jeffangelion/PicoPost/docs/images/schematic_lpc.png

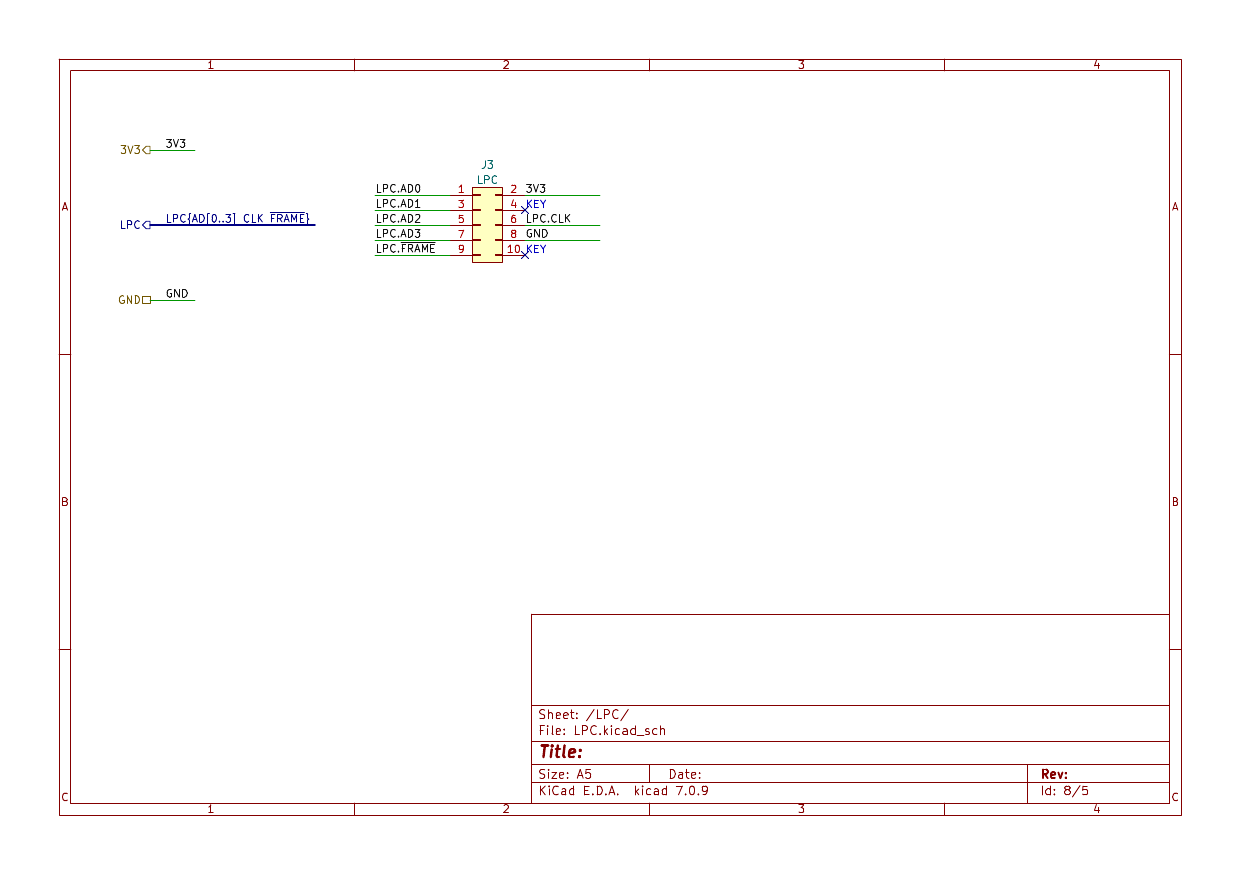
docs/images/schematic_lpc.png
