jeffangelion/PicoPost/docs/images/schematic_som.png

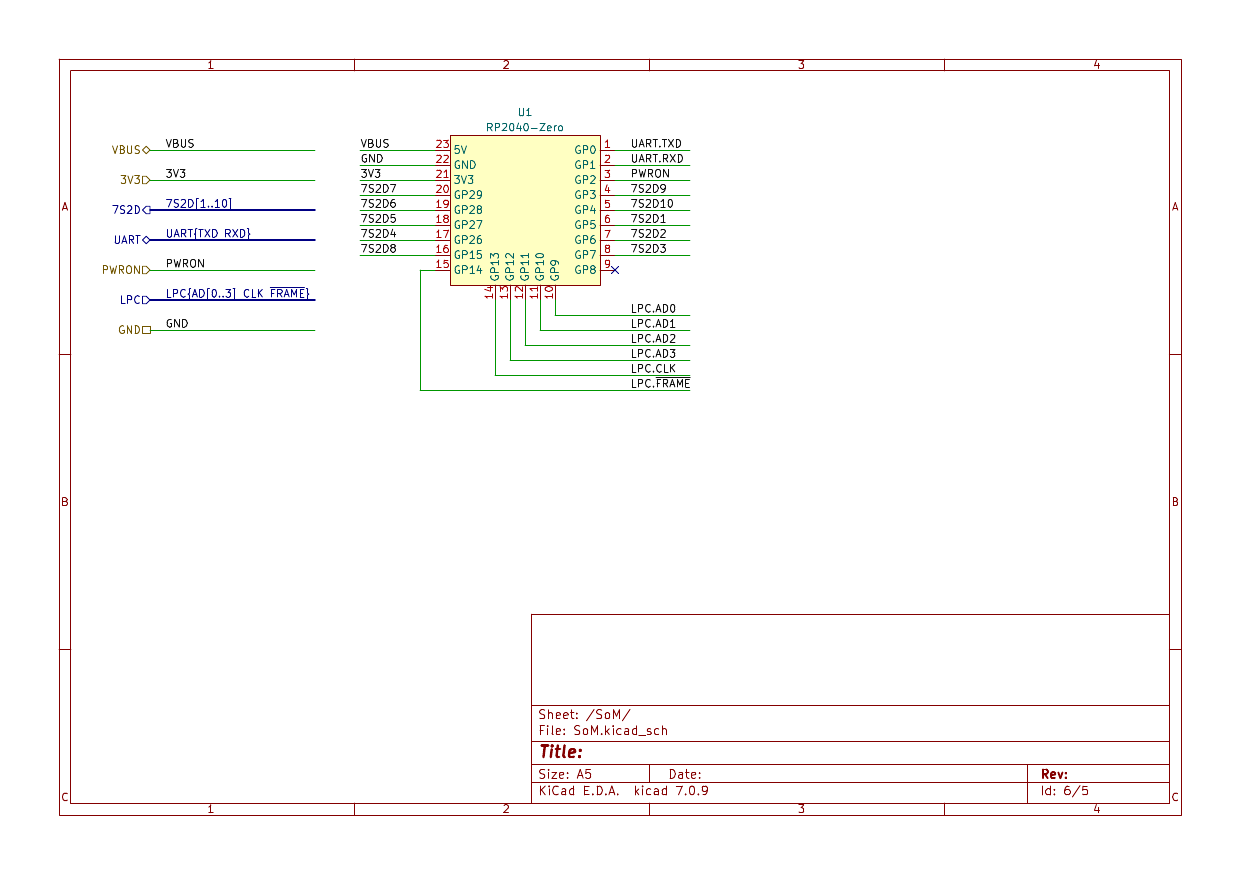
docs/images/schematic_som.png
