jeffangelion/PicoPost/hardware/enclosure/PicoPost_Case.step

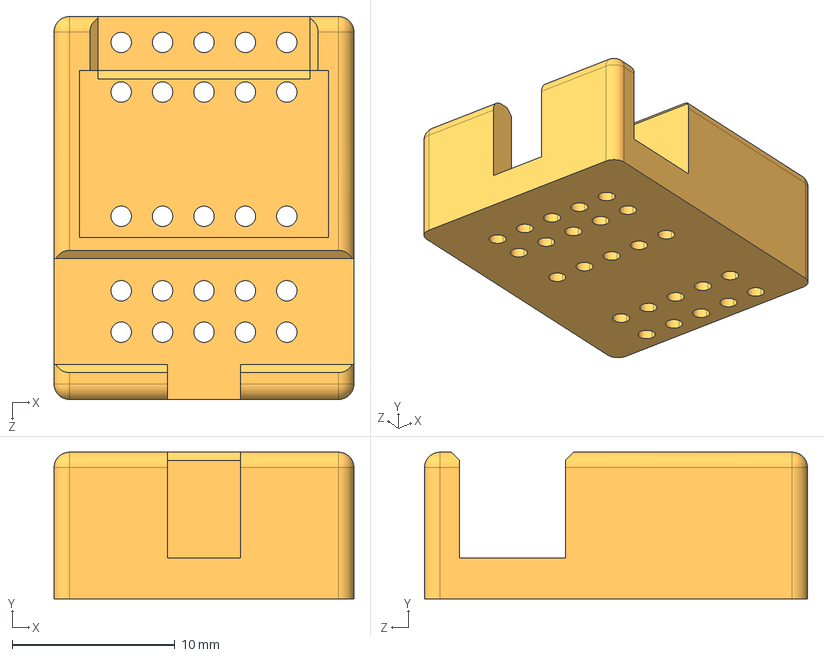
[picture p12: CAD file, 2026-11-07]
hardware/enclosure/PicoPost_Case.step
18.4 x 9.00 x 23.5 mm
