jeffangelion/PicoPost/hardware/kicad/PinHeader_2x05_P2.54mm_Vertical.step

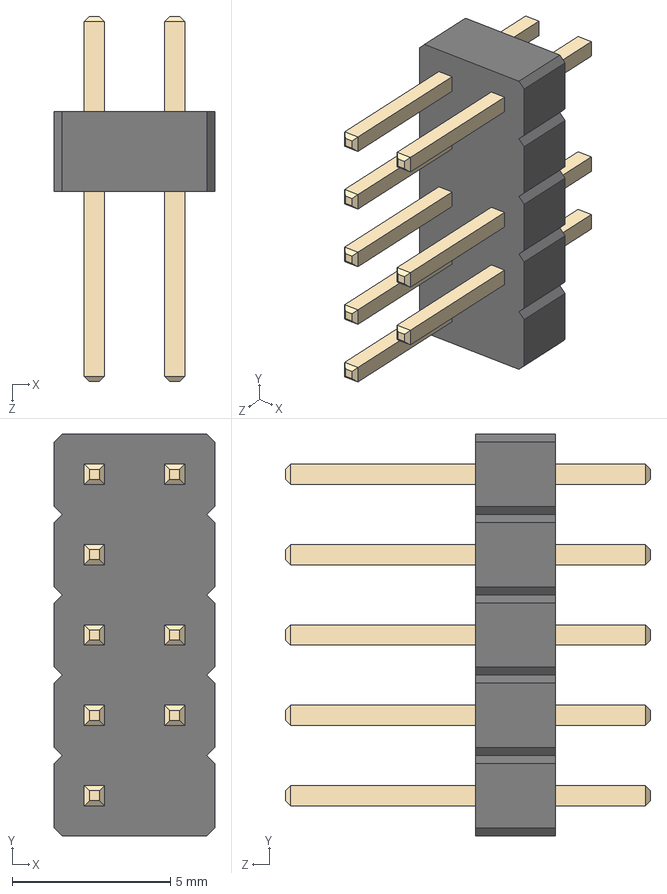
[picture p13: CAD file, 2026-11-07]
hardware/kicad/PinHeader_2x05_P2.54mm_Vertical.step
5.08 x 12.7 x 11.5 mm
