jeffangelion/PicoPost/hardware/PicoPost_Schematic.pdf

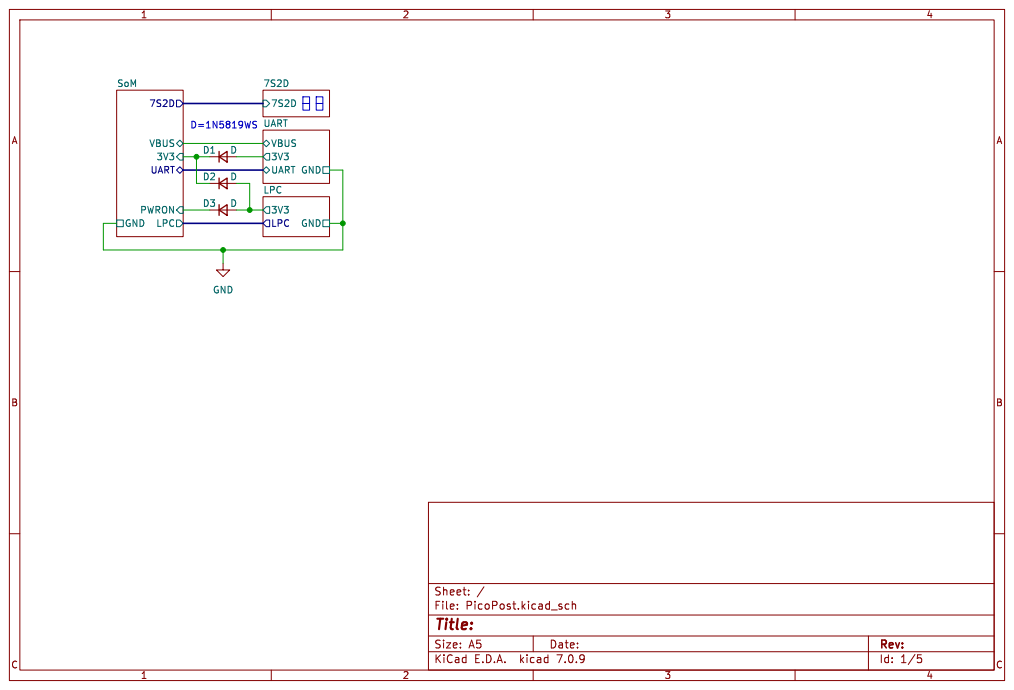
[picture p14: page 1]

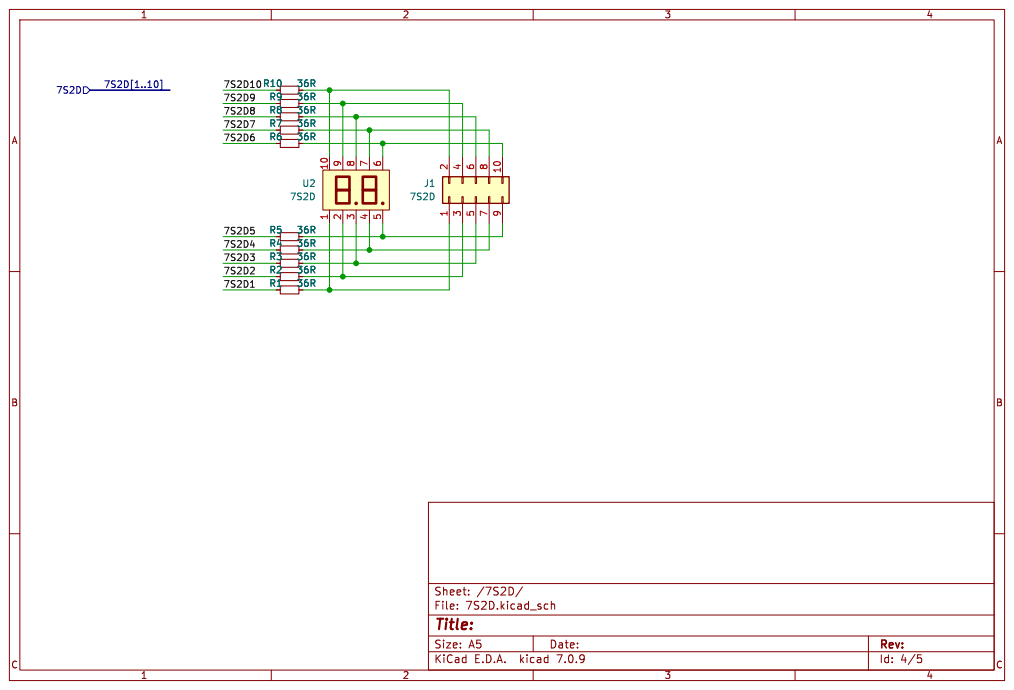
[picture p15: page 2]

Id: 4/5 Title: File: 7S2D.kicad_sch Sheet: /7S2D/

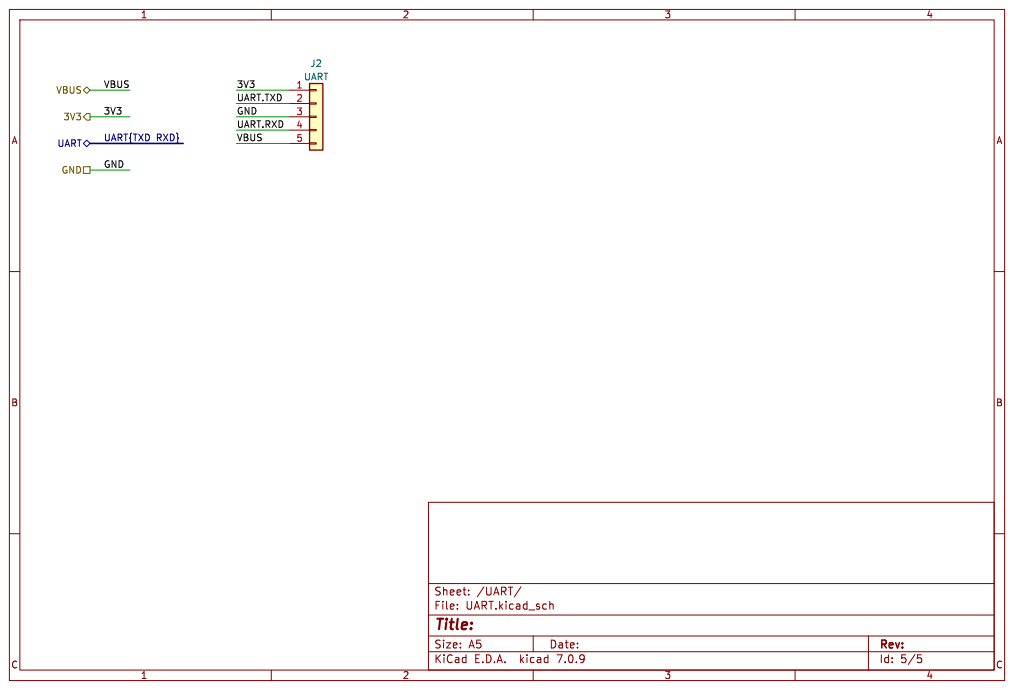
[picture p16: page 3]

UART{TXD RXD} GND

Id: 5/5 Title: File: UART.kicad_sch Sheet: /UART/

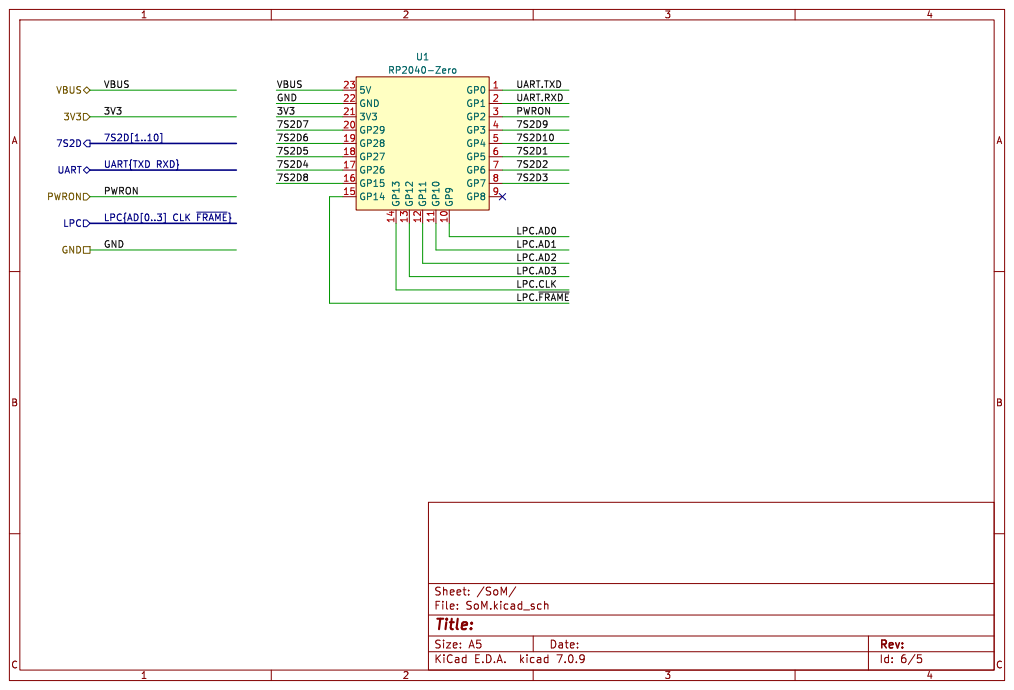
[picture p17: page 4]

UART{TXD RXD} GND

Id: 6/5 Title: File: SoM.kicad_sch Sheet: /SoM/

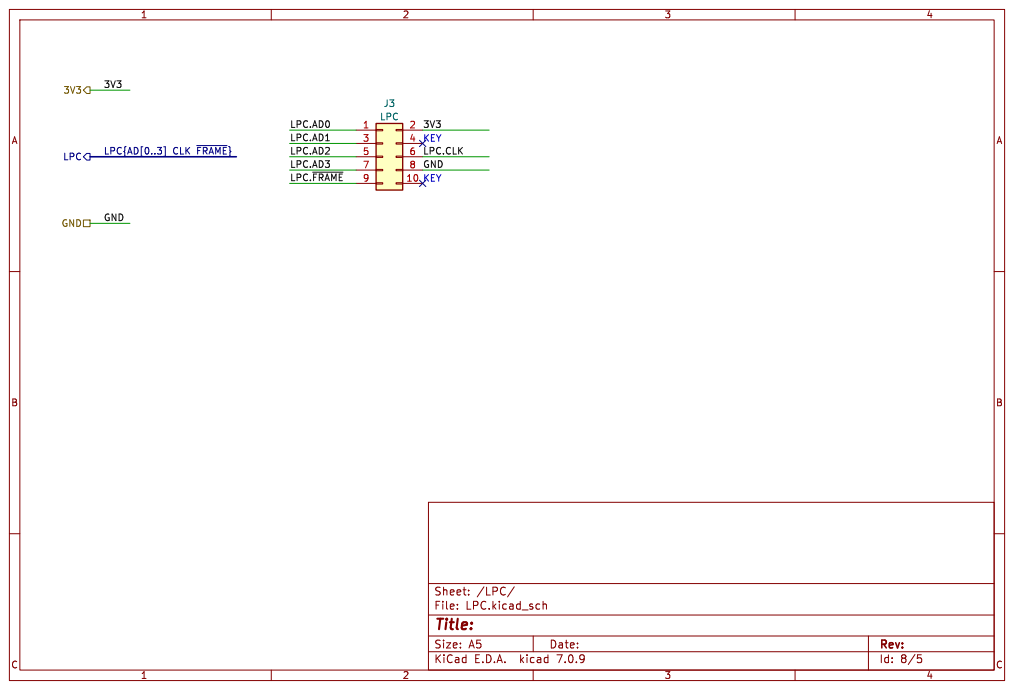
[picture p18: page 5]
