jeffangelion/PicoPost/hardware/kicad/PicoPost.kicad_pcb

## KiCad design hardware/kicad/PicoPost.kicad_pcb (2026-11-07)

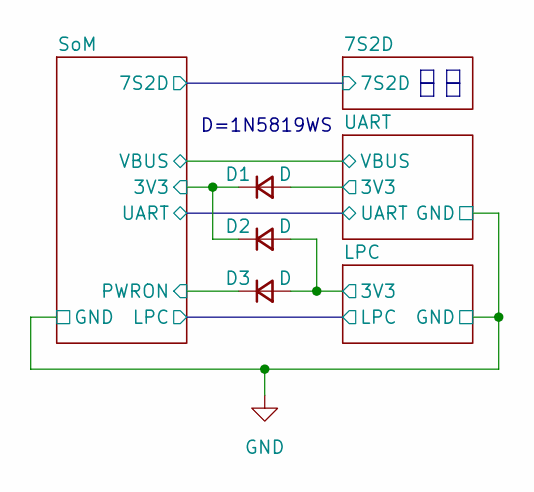
[picture p19: schematic PicoPost.kicad_sch]

Parts:
D1, D2, D3: D; D_SOD-323

Connections:
/LPC/3V3: D2.2 (A), D3.2 (A); also elsewhere on the board
/SoM/3V3: D1.1 (K), D2.1 (K); also elsewhere on the board
/SoM/PWRON: D3.1 (K); also elsewhere on the board
/UART/3V3: D1.2 (A); also elsewhere on the board

Notes on the sheet:
D=1N5819WS

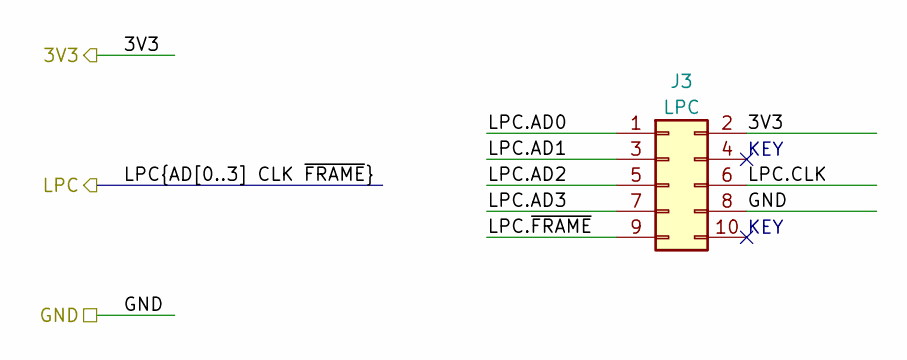
[picture p20: schematic LPC.kicad_sch]

Parts:
J3: LPC; PinHeader_2x05_P2.54mm_Vertical

Connections:
/LPC/3V3: J3.2; also elsewhere on the board
/LPC/LPC.AD0: J3.1; also elsewhere on the board
/LPC/LPC.AD1: J3.3; also elsewhere on the board
/LPC/LPC.AD2: J3.5; also elsewhere on the board
/LPC/LPC.AD3: J3.7; also elsewhere on the board
/LPC/LPC.CLK: J3.6; also elsewhere on the board
/LPC/LPC.~FRAME: J3.9; also elsewhere on the board
GND: J3.8; also elsewhere on the board

Notes on the sheet:
KEY

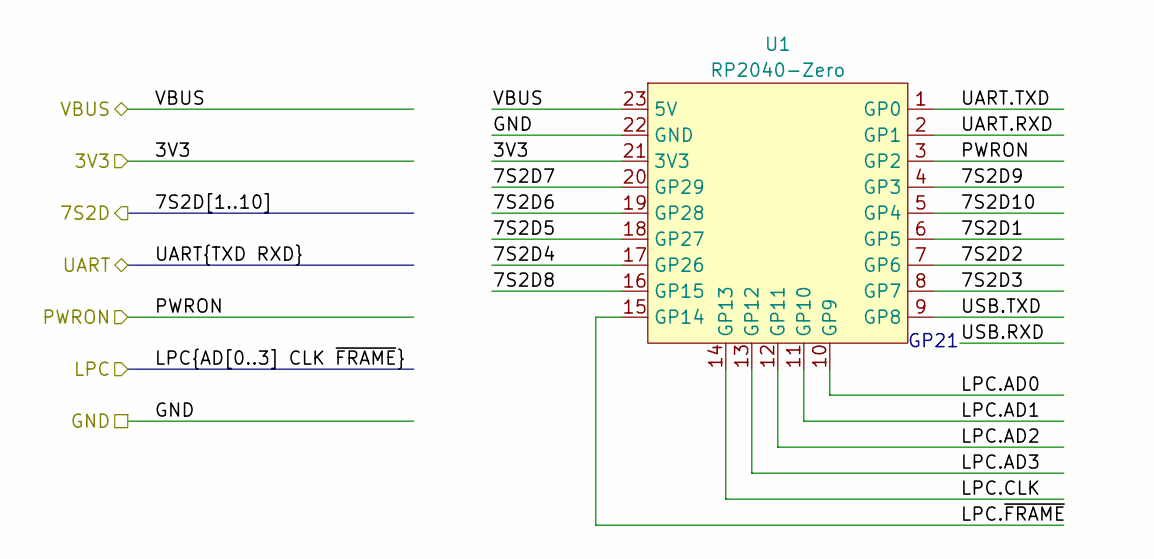
[picture p21: schematic SoM.kicad_sch]

Parts:
U1: RP2040-Zero; RP2040-Zero TNT

Connections:
/7S2D/7S2D1: U1.6 (GP5); also elsewhere on the board
/7S2D/7S2D2: U1.7 (GP6); also elsewhere on the board
/7S2D/7S2D3: U1.8 (GP7); also elsewhere on the board
/7S2D/7S2D4: U1.17 (GP26); also elsewhere on the board
/7S2D/7S2D5: U1.18 (GP27); also elsewhere on the board
/7S2D/7S2D6: U1.19 (GP28); also elsewhere on the board
/7S2D/7S2D7: U1.20 (GP29); also elsewhere on the board
/7S2D/7S2D8: U1.16 (GP15); also elsewhere on the board
/7S2D/7S2D9: U1.4 (GP3); also elsewhere on the board
/7S2D/7S2D10: U1.5 (GP4); also elsewhere on the board
/LPC/LPC.AD0: U1.10 (GP9); also elsewhere on the board
/LPC/LPC.AD1: U1.11 (GP10); also elsewhere on the board
/LPC/LPC.AD2: U1.12 (GP11); also elsewhere on the board
/LPC/LPC.AD3: U1.13 (GP12); also elsewhere on the board
/LPC/LPC.CLK: U1.14 (GP13); also elsewhere on the board
/LPC/LPC.~FRAME: U1.15 (GP14); also elsewhere on the board
/SoM/3V3: U1.21 (3V3); also elsewhere on the board
/SoM/PWRON: U1.3 (GP2); also elsewhere on the board
/SoM/UART.RXD: U1.2 (GP1); also elsewhere on the board
/SoM/UART.TXD: U1.1 (GP0); also elsewhere on the board
/SoM/VBUS: U1.23 (5V); also elsewhere on the board
GND: U1.22 (GND); also elsewhere on the board

Notes on the sheet:
GP21

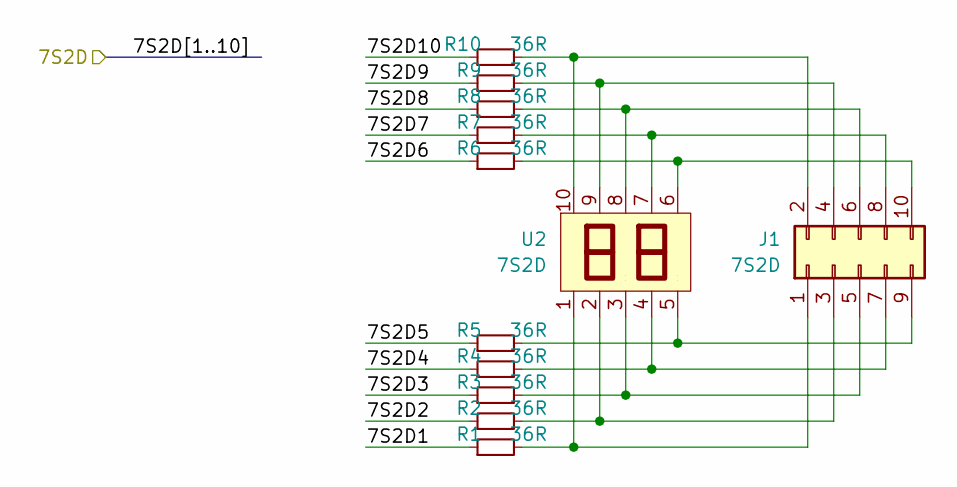
[picture p22: schematic 7S2D.kicad_sch]

Parts:
J1: 7S2D; PinHeader_2x05_P2.54mm_Vertical_SMD
R1, R2, R3, R4, R5, R6, R7, R8, R9, R10: 36R; R_0805_2012Metric
U2: 7S2D; Display_7S2D_10Pin_150x100

Connections:
/7S2D/7S2D1: R1.1; also elsewhere on the board
/7S2D/7S2D2: R2.1; also elsewhere on the board
/7S2D/7S2D3: R3.1; also elsewhere on the board
/7S2D/7S2D4: R4.1; also elsewhere on the board
/7S2D/7S2D5: R5.1; also elsewhere on the board
/7S2D/7S2D6: R6.1; also elsewhere on the board
/7S2D/7S2D7: R7.1; also elsewhere on the board
/7S2D/7S2D8: R8.1; also elsewhere on the board
/7S2D/7S2D9: R9.1; also elsewhere on the board
/7S2D/7S2D10: R10.1; also elsewhere on the board
unnamed: J1.1, R1.2, U2.1
unnamed: J1.2, R10.2, U2.10
unnamed: J1.3, R2.2, U2.2
unnamed: J1.4, R9.2, U2.9
unnamed: J1.5, R3.2, U2.3
unnamed: J1.6, R8.2, U2.8
unnamed: J1.7, R4.2, U2.4
unnamed: J1.8, R7.2, U2.7
unnamed: J1.9, R5.2, U2.5
unnamed: J1.10, R6.2, U2.6

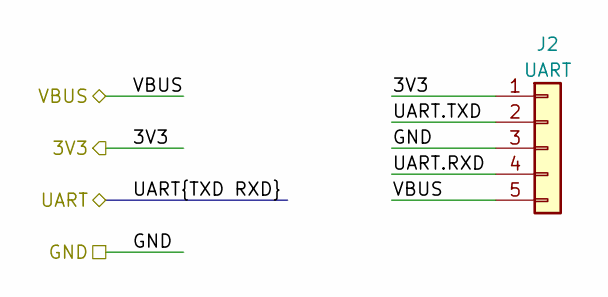
[picture p23: schematic UART.kicad_sch]

Parts:
J2: UART; PinHeader_1x05_P2.54mm_Vertical

Connections:
/SoM/UART.RXD: J2.4; also elsewhere on the board
/SoM/UART.TXD: J2.2; also elsewhere on the board
/SoM/VBUS: J2.5; also elsewhere on the board
/UART/3V3: J2.1; also elsewhere on the board
GND: J2.3; also elsewhere on the board

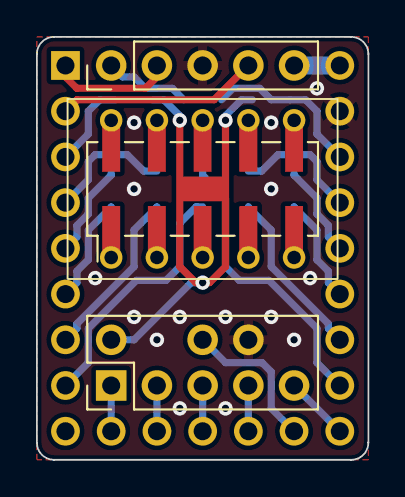
[picture p24: board PicoPost.kicad_pcb from above]

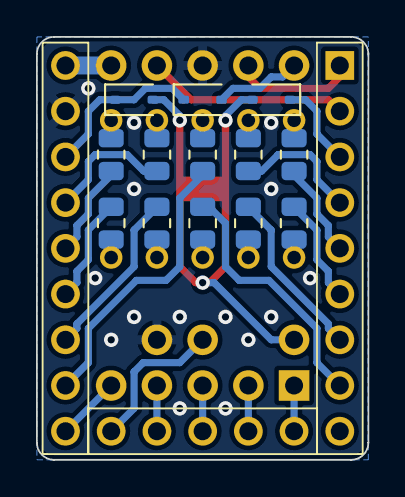
[picture p25: board PicoPost.kicad_pcb from below]

Board: 2 copper layers, 18.4 x 23.5 mm, 18 parts (14 on the bottom side), 34 nets.
