jeffangelion/PicoPost/(commit log)

2026-11-07 feat: initial release of PicoPost hardware, firmware, and CI workflow
    [7S2D.kicad_sch, LPC.kicad_sch, LPC_ASUS_10Pin.kicad_sch, LPC_GIGABYTE_12Pin.kicad_sch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]
2026-11-07 feat(docs): add live boot animations, ROG AM4 test bench photos, and 3D enclosure preview
2026-11-12 Update README_ru.md: убраны лишние картинки
